Safaet-islam/ymfc-al-arduino-quadcopter/README.md

# YMFC-AL Arduino Quadcopter

An Arduino-based quadcopter built on Joop Brokking’s YMFC-AL project. This project features custom PID tuning, motor balancing, and future plans for GPS-based failsafe and PC route control.

---

## ✈️ Overview

This project documents the design, assembly, and tuning of a custom-built YMFC-AL Arduino quadcopter. The code is adapted from Joop Brokking’s original YMFC-AL codebase, with personal modifications for stability and performance.

---

## 🛠️ Features

- Arduino-based flight controller (Uno)
- MPU6050 gyroscope/accelerometer
- Custom PID tuning for stable flight
- Motor balancing and trimming
- Future GPS integration for failsafe return-to-home
- Planned PC-based route control

---

## 📂 Repository Contents

- `ymfc-al-arduino-quadcopter.ino`: The main Arduino sketch.
- `README.md`: This documentation file.
- Additional supporting files as needed.

---

## 🔧 Hardware Used

- Arduino Uno
- MPU6050 Gyroscope/Accelerometer
- Electronic Speed Controllers (ESCs)
- Brushless DC Motors
- Quadcopter Frame
- Propellers
- 3S 11.1V 1100mAh LiPo Battery
- F450 Frame with power distribution board

---

## 🔌 Circuit Diagram

Visit my project documentation for a detailed circuit diagram and photos of the final build.

---

## 📸 Photos

See the project documentation for detailed photos of the build.

---

## 👨‍💻 Getting Started

1. Upload the Arduino sketch to your Arduino Uno.
2. Assemble the hardware as per the circuit diagram.
3. Perform initial PID tuning using the onboard calibration.
4. Trim pitch and roll offsets as needed.
5. Fly and test!

---

## 📖 Additional Documentation

Check out the complete project documentation here:  
👉 (https://github.com/Safaet-islam/ymfc-al-arduino-quadcopter/blob/main/Documentation/YMFC-AL_Arduino_Quadcopter_Project_Documentation.pdf)

---

## 🌐 Resources

- Visit Joop Brokking’s YMFC-AL site for the original project:  
  [http://www.brokking.net/ymfc-al_main.html](http://www.brokking.net/ymfc-al_main.html)

---

## 🤝 Credits

- Original code by Joop Brokking.
- Custom modifications, testing, and tuning by Safaet Islam Pranto.

---

## 📜 License

This project is open-source and intended for educational and personal use only. Please give credit to the original creator (Joop Brokking) when using or modifying this code.

---
